madhunm/blitzbox2561cj125/README.md

# blitzbox2561cj125
low-cost and mini-sized ECU for speeduino firmware (50.1 x 58.6 mm)

2 injectors (max. 2.8A per channel)<br/>
4 active ignition coils or 1 passive ignition coil with separate ground plane<br/>
1 crankshaft sensor with VR-conditioner<br/>
5 analog inputs: CLT, IAT, TPS, BAT, MAP (MPXH6400A)<br/>

Onboard Wideband Lambda Controller with Bosch CJ125 (LSU 4.9)<br/>

1 fuel pump out<br/>
1 idle valve out<br/>
1 tacho out<br/>

Pinheader:
1 free and non-wired general purpose I/O (analog or digital)<br/>
1 I2C
1 second serial TTL<br/>
USB programming interface with PL2303SA (Tunerstudio)<br/>

all in/outputs can be defined different in firmware

[Link to the original speeduino project](https://www.speeduino.com "speeduino homepage")

<p align="center">
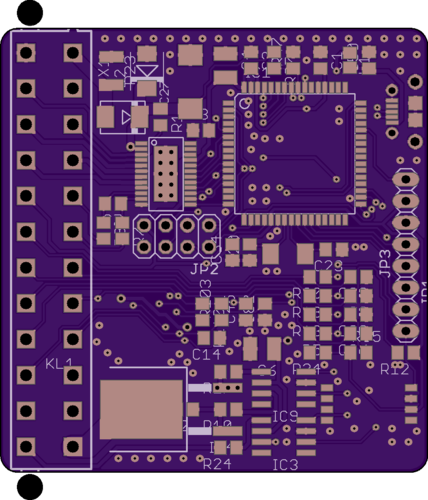
[picture p1: hardware/Rev_0.1/top.png]
  
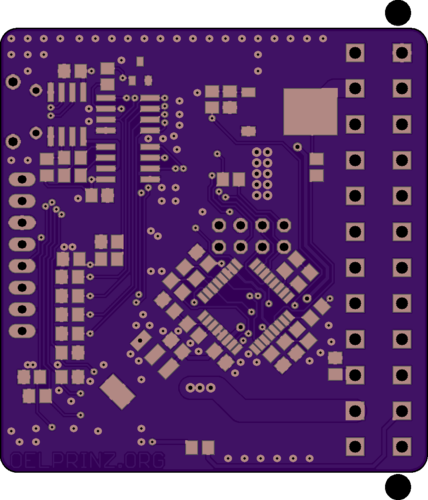
[picture p2: hardware/Rev_0.1/bottom.png]
  <br/>
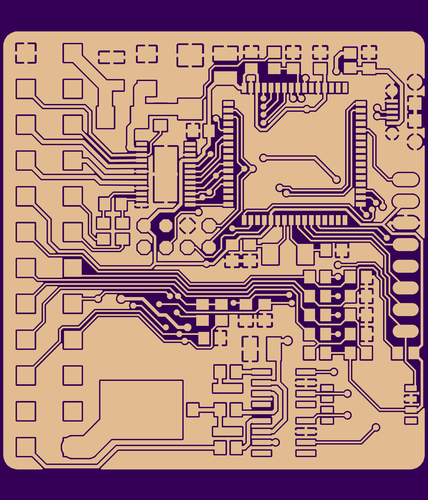
[picture p3: hardware/Rev_0.1/top_layer.png]
    
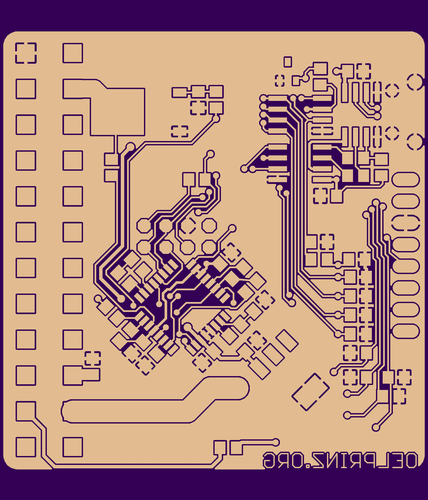
[picture p4: hardware/Rev_0.1/bottom_layer.png]
  
</p>
