madhunm/blitzbox2561cj125/hardware/Rev_0.1/schematics.pdf

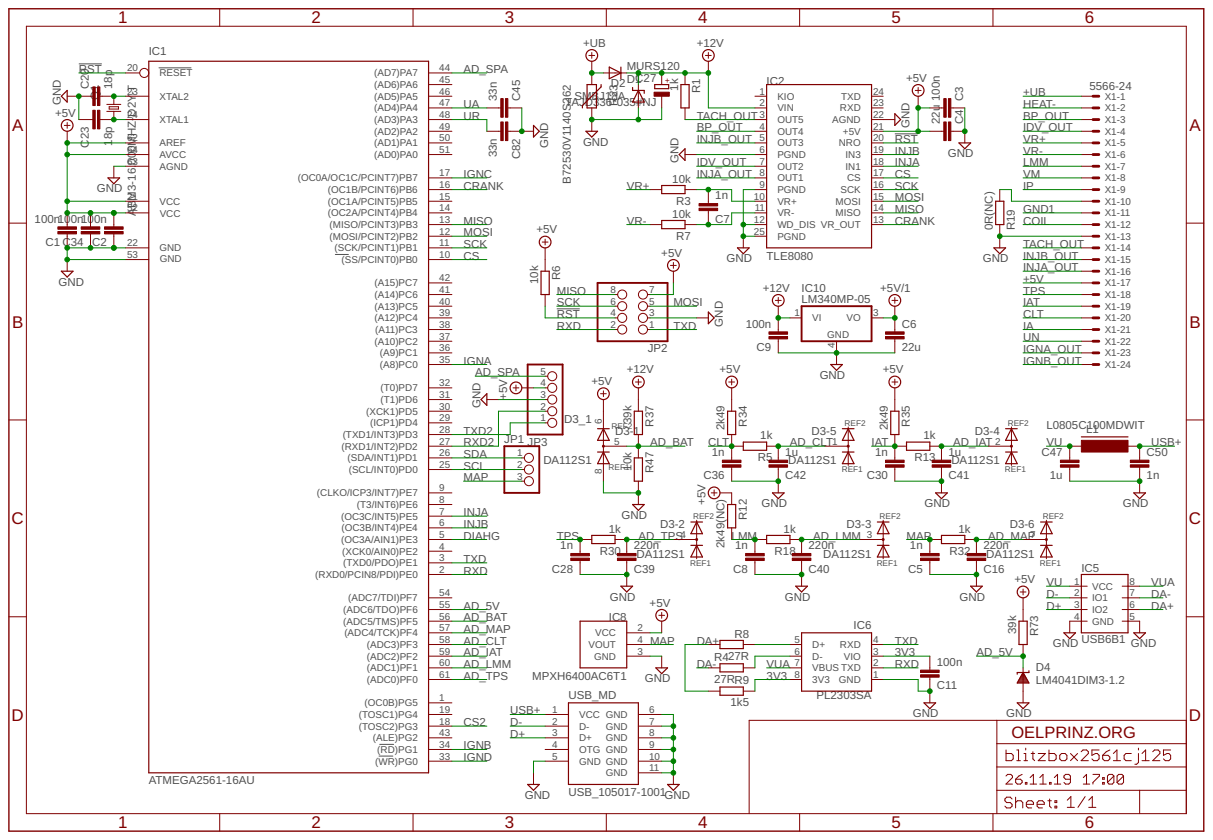
[picture p5: page 1]
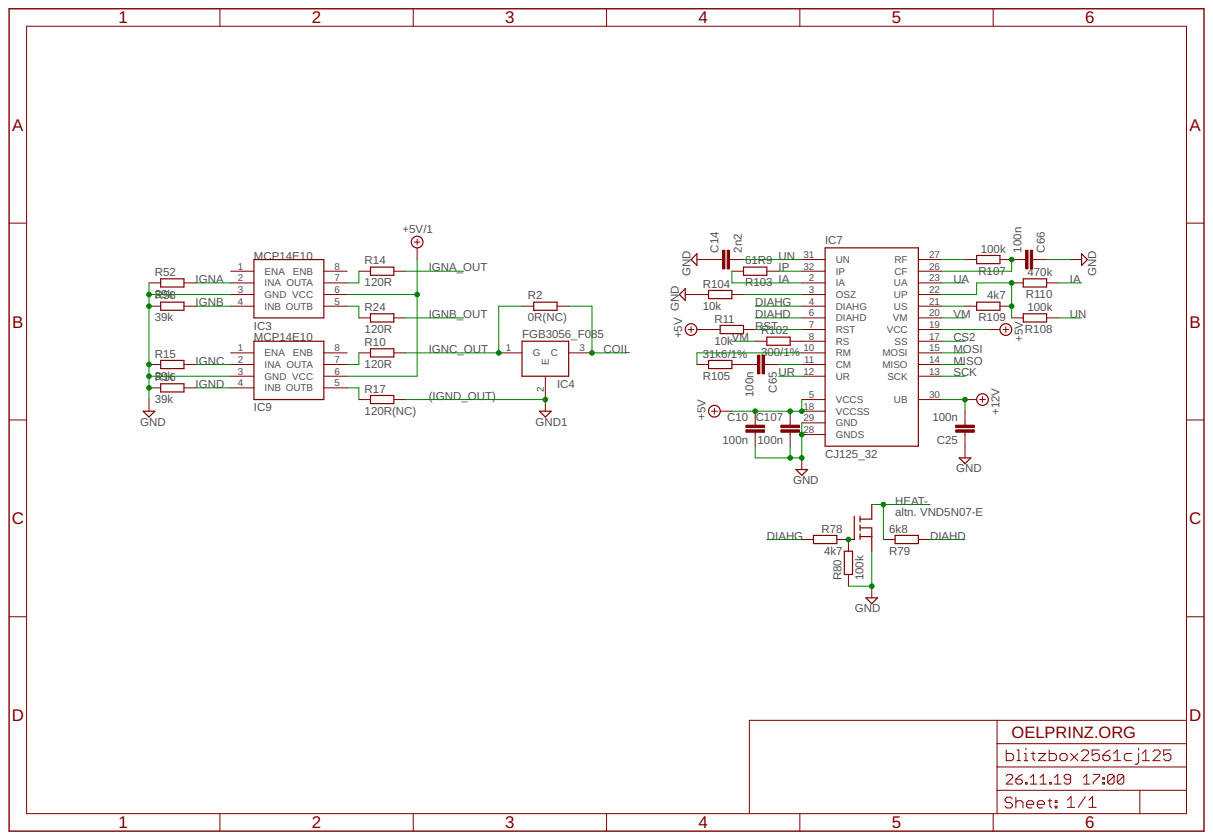
[picture p6: page 2]
